bdubs784/camera_guided_robot_arm/hardware/cad/arm/shoulder_gearbox.step

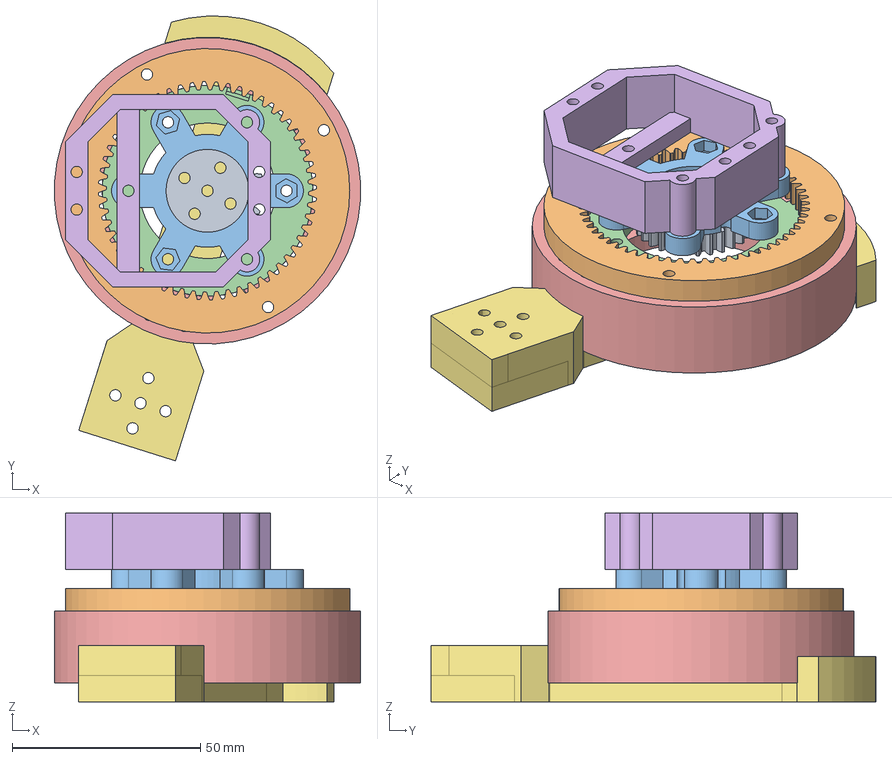
[picture p10: CAD file, 2026-10-27]
hardware/cad/arm/shoulder_gearbox.step
81.3 x 118.2 x 50.2 mm
