bdubs784/camera_guided_robot_arm/hardware/cad/rigid_parts/meshes/upper_arm_1.stl

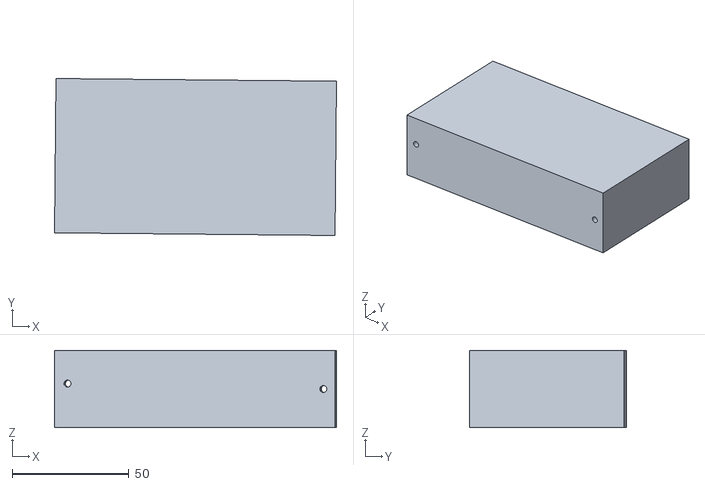
[picture p11: CAD file, 2026-10-27]
hardware/cad/rigid_parts/meshes/upper_arm_1.stl
120.6 x 67.1 x 33.0
