bdubs784/camera_guided_robot_arm/sim/arm_twin/meshes/tower_1.stl

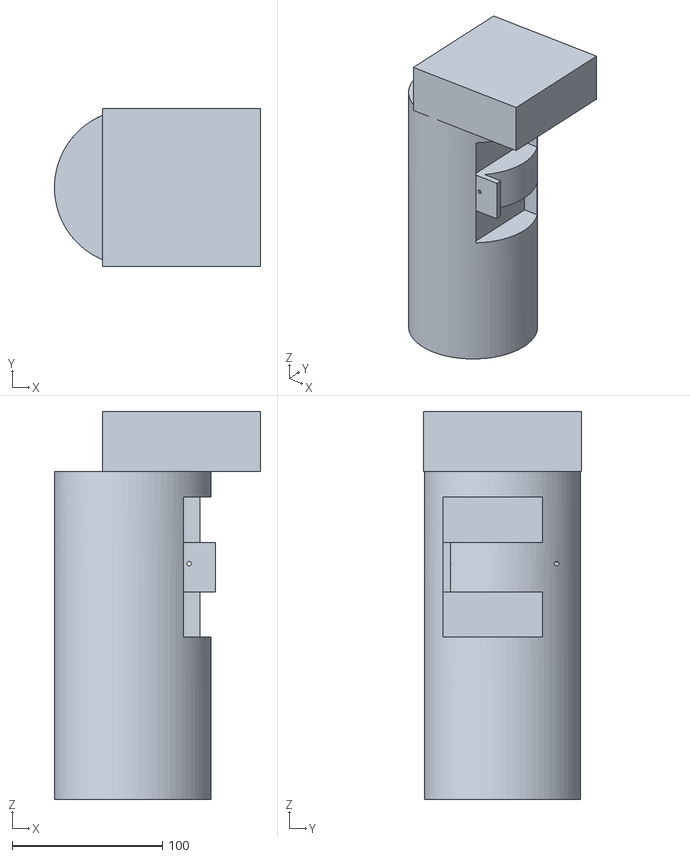
[picture p12: CAD file, 2026-10-27]
sim/arm_twin/meshes/tower_1.stl
137.0 x 105.0 x 257.8
