bdubs784/camera_guided_robot_arm/sim/gripper_sim/meshes/link_l.stl

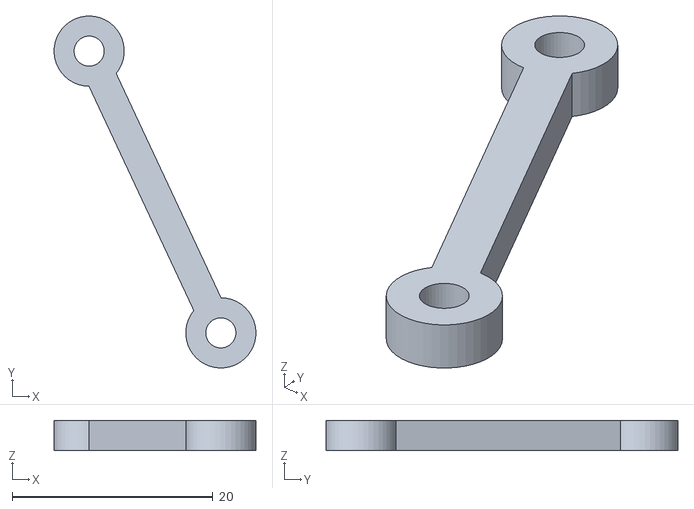
[picture p13: CAD file, 2026-10-27]
sim/gripper_sim/meshes/link_l.stl
20.1 x 35.1 x 3.00
