bdubs784/camera_guided_robot_arm/hardware/cad/arm/arm_links.step

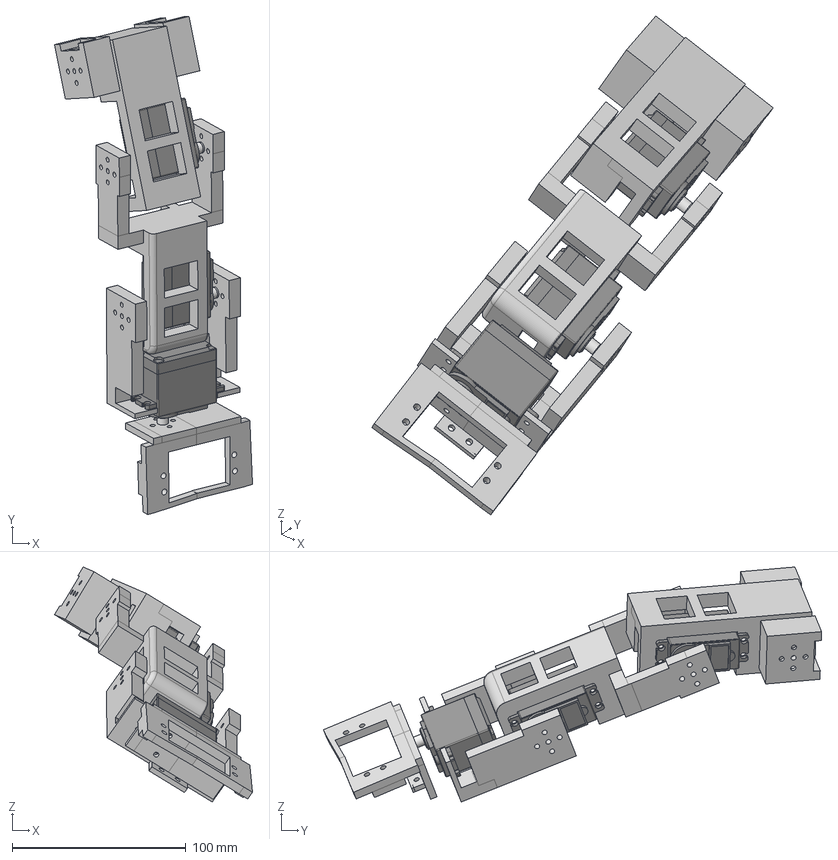
[picture p14: CAD file, 2026-10-27]
hardware/cad/arm/arm_links.step
113.9 x 286.5 x 135.1 mm
Servo Motor Model(MG996R)
Servo Motor Model(MG996R)_1
Servo Motor Model(MG996R)_2
