bdubs784/camera_guided_robot_arm/hardware/cad/rigid_parts/meshes/wrist_1.stl

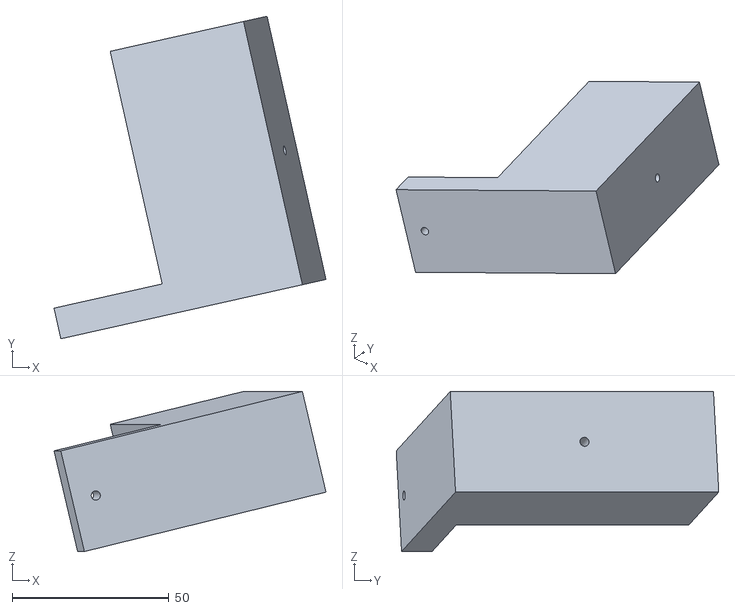
[picture p15: CAD file, 2026-10-27]
hardware/cad/rigid_parts/meshes/wrist_1.stl
86.7 x 102.8 x 51.0
