bdubs784/camera_guided_robot_arm/sim/gripper_sim/meshes/gear_l.stl

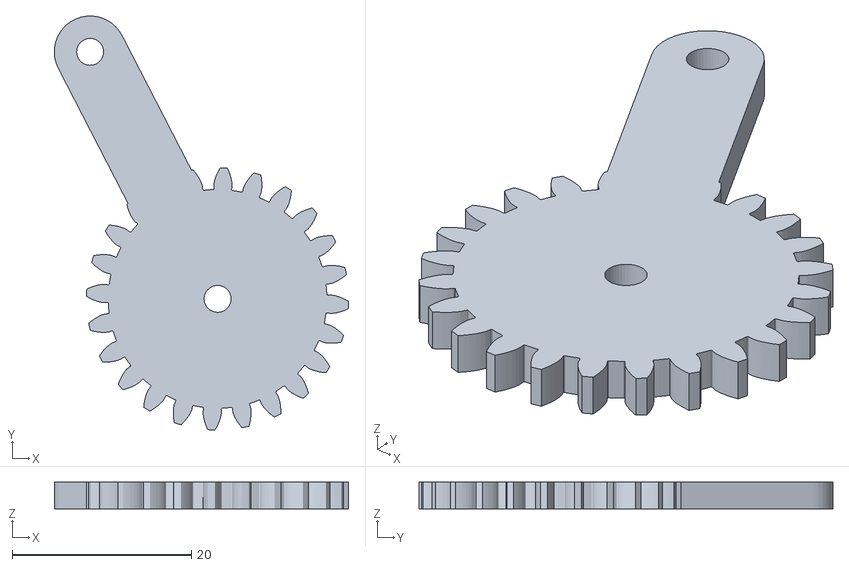
[picture p16: CAD file, 2026-10-27]
sim/gripper_sim/meshes/gear_l.stl
32.8 x 46.2 x 3.00
