bdubs784/camera_guided_robot_arm/hardware/cad/arm/gripper.step

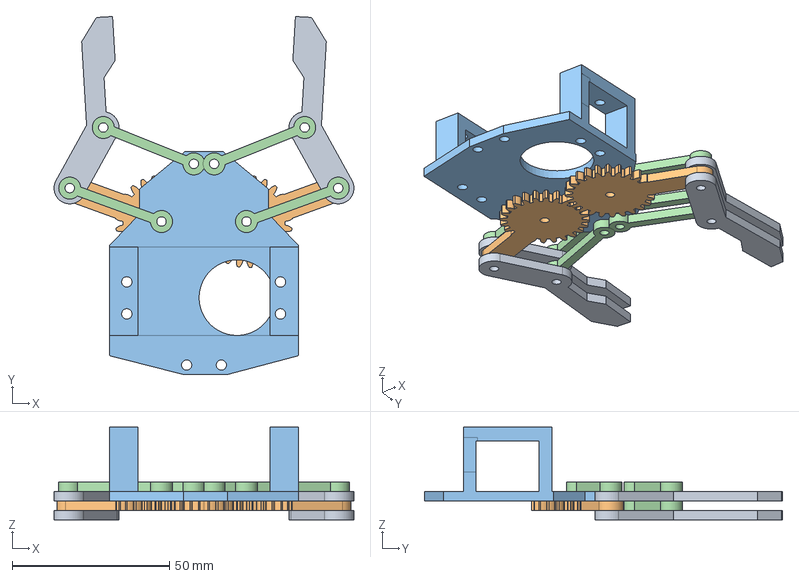
[picture p17: CAD file, 2026-10-27]
hardware/cad/arm/gripper.step
95.3 x 113.7 x 29.5 mm
