bdubs784/camera_guided_robot_arm/hardware/cad/rigid_parts/meshes/forearm_1.stl

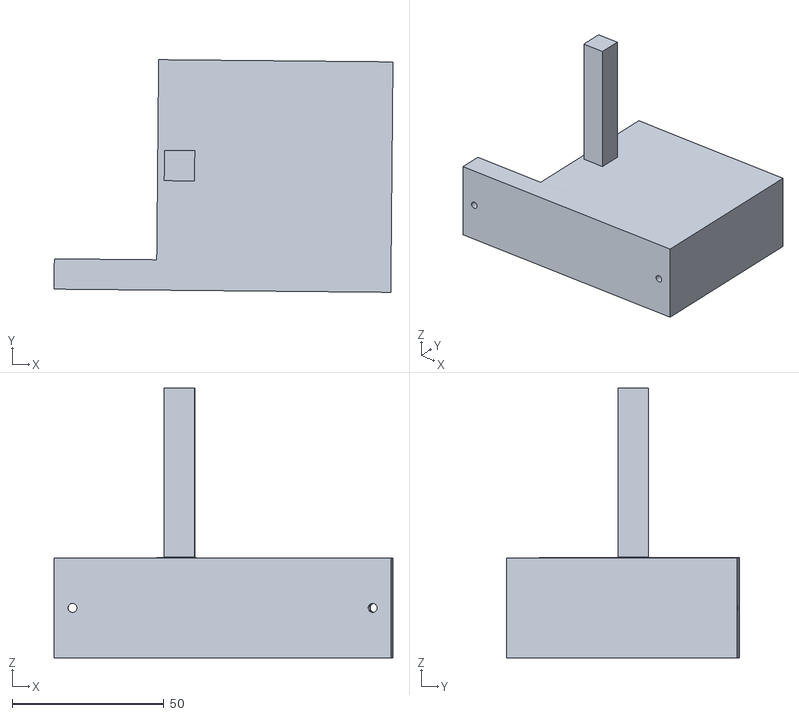
[picture p18: CAD file, 2026-10-27]
hardware/cad/rigid_parts/meshes/forearm_1.stl
111.8 x 76.7 x 89.0
