bdubs784/camera_guided_robot_arm/sim/arm_twin/meshes/floor_1.stl

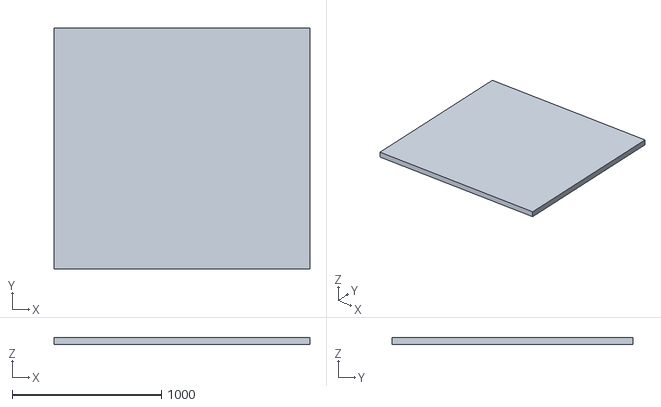
[picture p19: CAD file, 2026-10-27]
sim/arm_twin/meshes/floor_1.stl
1713.0 x 1613.0 x 50.0
