bdubs784/camera_guided_robot_arm/hardware/cad/arm/tower.step

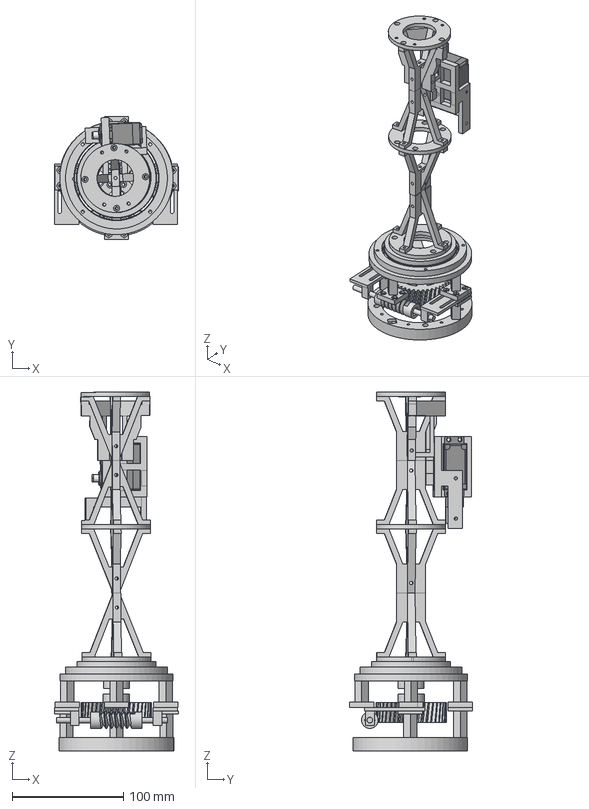
[picture p20: CAD file, 2026-10-27]
hardware/cad/arm/tower.step
111.9 x 110.8 x 323.0 mm
