bdubs784/camera_guided_robot_arm/hardware/cad/rigid_parts/meshes/hand_1.stl

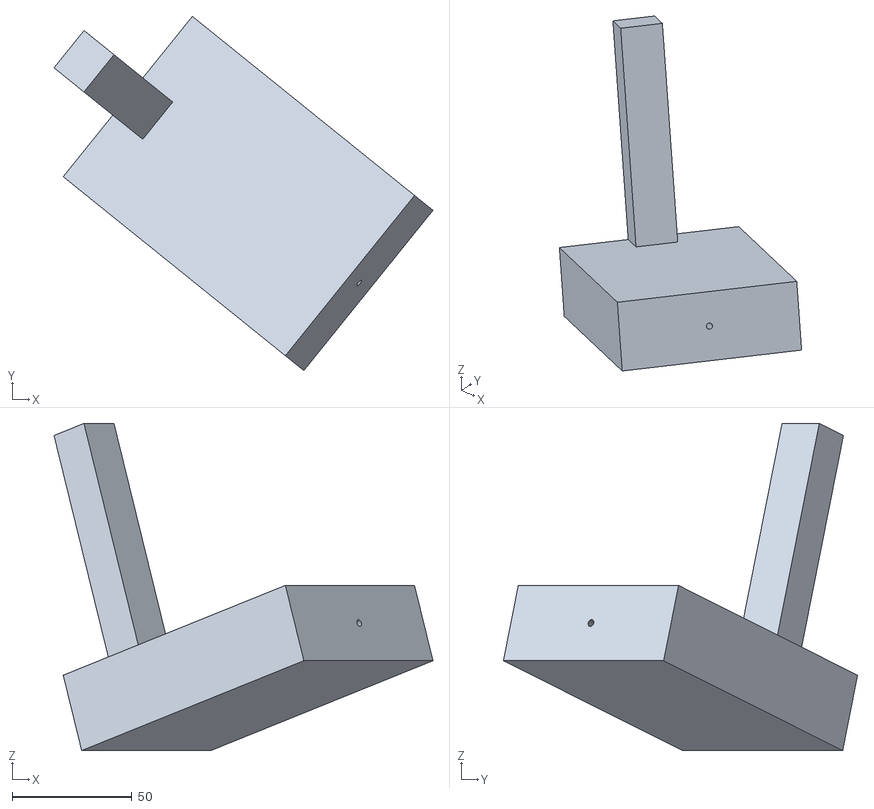
[picture p21: CAD file, 2026-10-27]
hardware/cad/rigid_parts/meshes/hand_1.stl
158.4 x 148.0 x 136.7
