bdubs784/camera_guided_robot_arm/sim/gripper_sim/meshes/finger_l.stl

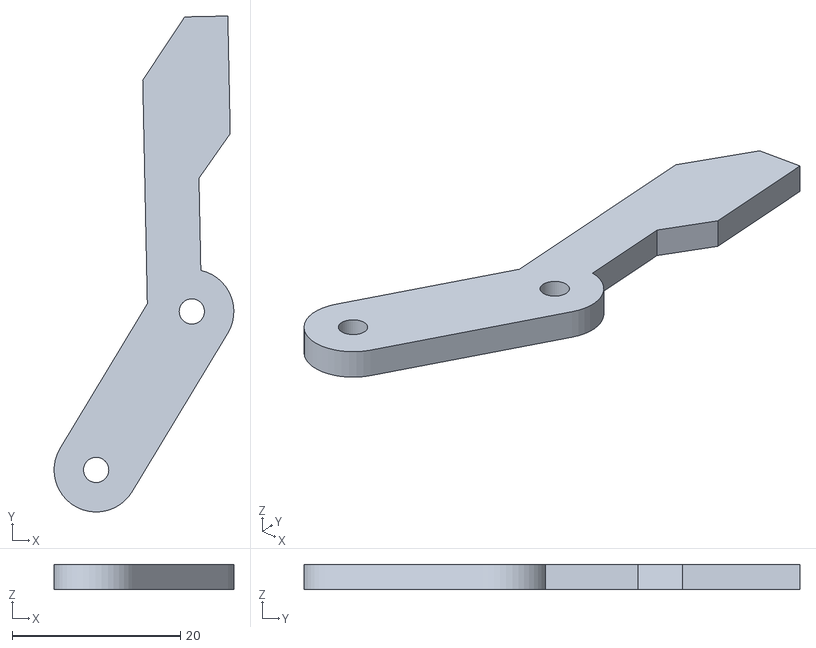
[picture p22: CAD file, 2026-10-27]
sim/gripper_sim/meshes/finger_l.stl
21.4 x 59.0 x 3.00
