bdubs784/camera_guided_robot_arm/hardware/cad/rigid_parts/meshes/plywood_and_base_1.stl

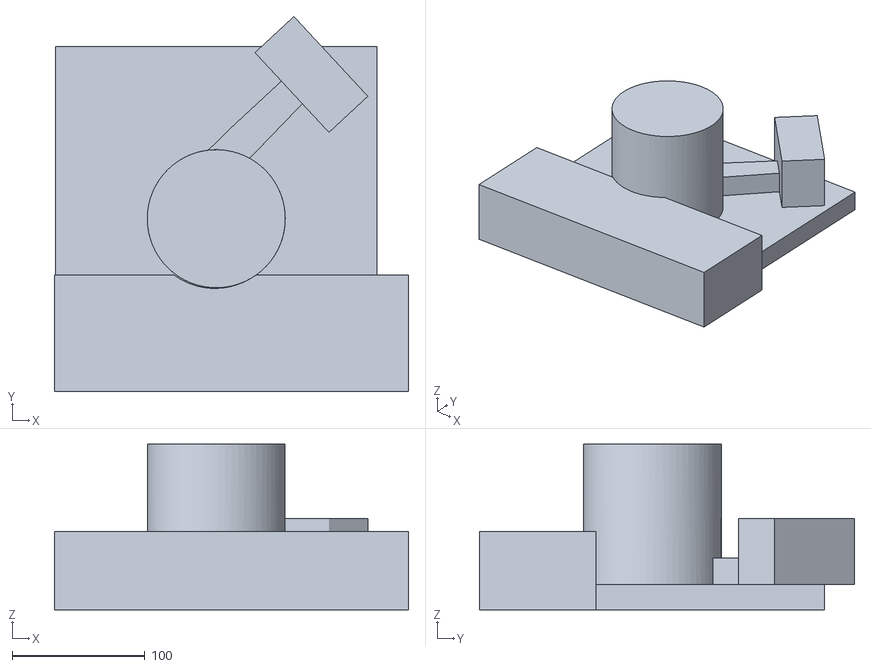
[picture p23: CAD file, 2026-10-27]
hardware/cad/rigid_parts/meshes/plywood_and_base_1.stl
267.0 x 282.6 x 125.0
