bdubs784/camera_guided_robot_arm/sim/arm_twin/meshes/grip_body.stl

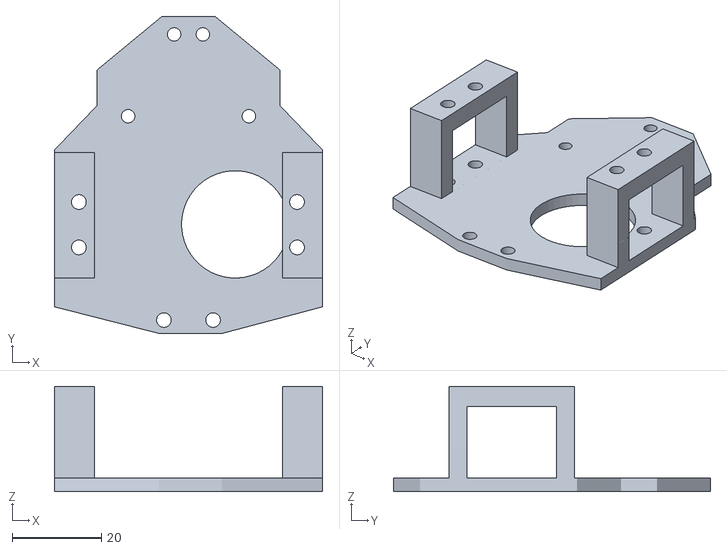
[picture p24: CAD file, 2026-10-27]
sim/arm_twin/meshes/grip_body.stl
60.0 x 70.9 x 23.5
