bdubs784/camera_guided_robot_arm/sim/arm_twin/meshes/plywood_and_base_1.stl

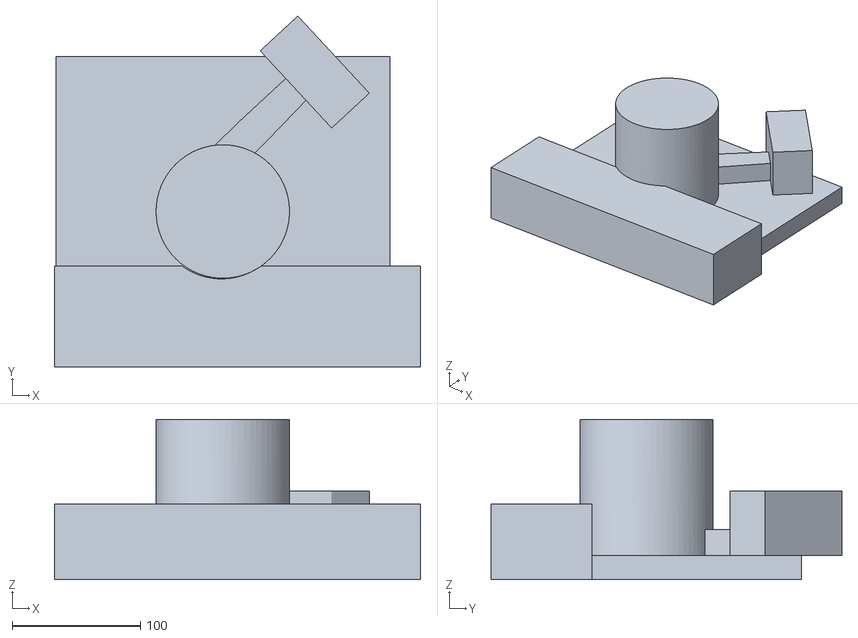
[picture p25: CAD file, 2026-10-27]
sim/arm_twin/meshes/plywood_and_base_1.stl
285.4 x 273.6 x 125.0
