bdubs784/camera_guided_robot_arm/(list of files, cad)

Other CAD files:
sim/arm_twin/meshes/grip_link_r.stl
sim/gripper_sim/meshes/link_r.stl
sim/arm_twin/meshes/grip_gear_r.stl
sim/gripper_sim/meshes/gear_r.stl
sim/gripper_sim/meshes/finger_r.stl
sim/arm_twin/meshes/grip_finger_r.stl
